Rodrig087/Digitalizador/Leeme.txt

Contiene los archivos de hardware, software y firmware de un digitalizador de 3 canales y 12 bits de resolucion.
