Rodrig087/Digitalizador/Documentacion/Esquematico_V2.pdf

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
Altium Limited
L3, 12a Rodborough Rd
Frenchs Forest
NSW
* | Australia 2086

*

* | *
7/12/2021 | 19:02:05
G:\My Drive\IVAN PALACIOS\Digitalizador\Digitalizador 3 Canales - RPi\PCB\Digitalizador_RPi_V2\Digitalizador_RPi\Digitalizador_RPi.SchDoc

Title

Size: | Number:
Date:
File:

Revision:
Time: | Sheet | of

A1

## ENTRADA Y SALIDA DE ALIMENTACIONES - CONEXIÓN GEÓFONO Y ACELERÓMETRO ETNA

20pF

1 2

C25

CL21C200JBANNNC

20pF

1 2

C26

CL21C200JBANNNC

MCLR 1
AN0/VREF+/CN2/RB0 2
AN1/VREF-/CN3/RB1 3
AN2/SS1/LVDIN/CN4/RB2 4
AN3/CN5/RB3 5
AN4/IC7/CN6/RB4 6
AN5/IC8/CN7/RB5 7
PGC/EMUC/AN6/OCFA/RB6 8
PGD/EMUD/AN7/RB7 9
AN8/RB8 10
VDD_1 11
VSS_1 12
OSC1/CLKI 13
OSC2/CLKO/RC15 14
EMUD1/SOSCI/T2CK/U1ATX/CN1/RC13 15 EMUC1/SOSCO/T1CK/U1ARX/CN0/RC14 16 INT0/RA11 17
IC2/INT2/RD9 18
OC4/RD3 19
VSS_2 20
AVDD | 40
AVSS | 39
AN9/CSCK/RB9 | 38
AN10/CSDI/RB10 | 37
AN11/CSDO/RB11 | 36
AN12/COFS/RB12 | 35
EMUC2/OC1/RD0 | 34
EMUD2/OC2/RD1 | 33
VDD_3 | 32
VSS_3 | 31
C1RX/RF0 | 30
C1TX/RF1 | 29
U2RX/CN17/RF4 | 28
U2TX/CN18/RF5 | 27
U1RX/SDI1/SDA/RF2 | 26
EMUD3/U1TX/SDO1/SCL/RF3 | 25
EMUC3/SCK1/RF6 | 24
IC1/INT1/RD8 | 23
OC3/RD2 | 22
VDD_2 | 21

IC2

DSPIC30F4013-30I_P

100nF ¹ 2
C20

10nF ¹ 2
C21 1 2 D1

1N4148W

4K7 ¹ ² R13
0603WAF4701T5E

MCLR

+5V

GND

OSC1

OSC2

OSC1
OSC2

+5V

GND 1 2

Y1
ECS-150-S-4X

PGC_A3_5V
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
PEINETA-6X1P GRABADOR

MCLR

+5V

GND

PGC_A3_5V

PGD

A2_5V

A1_5V

A0_5V

VREF_+5V
SIGNAL3
SIGNAL2
SIGNAL1

TX_GPS_5V

RX_GPS

EN_GPS

+5V_AVDD
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
PPS_GPS_5V

## DISPOSITIVO PRINCIPAL DSPIC30F4013 Y ADC

1uF ¹ 2
C19

100nF ¹ 2
C23

10nF ¹ 2
C24

+5V_AVDD

GND

1uF ¹ 2
C22

## CONVERSORES DE NIVEL PARA MULTIPLEXORES

2 3 ¹

Q6
2N7002

+2.5V +5V

A0_2.5V | A0_5V

2 3 ¹

Q11
2N7002

+2.5V +5V

A1_2.5V | A1_5V

1K ¹ 2
R20

1K ¹ 2
R21

1K ¹ 2
R38

1K ¹ 2
R39

2 3 ¹

Q7
2N7002

+2.5V +5V

A2_2.5V | A2_5V

2 3 ¹

Q12
2N7002

+2.5V +5V

A3_2.5V | PGC_A3_5V

1K ¹ 2
R22

1K ¹ 2
R23

1K ¹ 2
R40

1K ¹ 2
R41
PPS_DS3231 | SDA_DS3231

RST_DS3231

SCL_DS3231

MOSI_RPI_5V
MISO_RPI_5V
SCK_RPI_5V

CS_RPI_5V

PIN_EXTRA_5V

INT_FROM_PIC_5V

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
Blue

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
CH1+
CH1-
CH2+
CH2-
CH3+
CH3-

1
2
3
4
5
6

P3

SEÑALES GEOFONO

1
2
3
4

P4

ALIMENTACION GEOFONO
+12V
-12V

GND

100nF ¹ 2
C8

-12V

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
11 11
13 13
15 15
17 17
19 19

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
10 10
12 12
14 14
16 16
18 18
20 20

J1

CONECTOR ACELEROMETRO

CH3+

CH2-

CH3-

CH1+

CH2+

CH1- -12V

GND

+12V

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
ENTRADA_ALIMENTACION_1

GND

+5V
+3.3V

+2.5V
-2.5V

+12V
-12V

+8V
-8V

GND

+5V_CONM

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
ENTRADA_ALIMENTACION_2

100nF ¹ 2
C7

+12V

GND

2 3 ¹

Q1
2N7002

+3.3V +5V

TX_GPS_3.3V | TX_GPS_5V

TX_GPS_3.3V
RX_GPS

EN_GPS

2 3 ¹

Q2
2N7002

+3.3V +5V

PPS_GPS_3.3V | PPS_GPS_5V
+5V

GND

PPS_GPS_3.3V

## CONEXIÓN GPS

100nF ¹ 2
C2

10nF ¹ 2
C3

+5V

GND

1uF ¹ 2
C1
1K ¹ 2
R4

1K ¹ 2
R5

1K ¹ 2
R8

1K ¹ 2
R9

## REFERENCIA DE VOLTAJES +5V Y +2.5V

VDD 1
DATA 2
NULL 3
GND 4

IC3

DHT22

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
11 11
13 13
15 15
17 17
19 19
21 21
23 23
25 25
27 27
29 29
31 31
33 33
35 35
37 37
39 39

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
10 10
12 12
14 14
16 16
18 18
20 20
22 22
24 24
26 26
28 28
30 30
32 32
34 34
36 36
38 38
40 40

J2

PEINETA-2X20P

+3.3V

GND | GND

+5V_CONM

GND

+3.3V | +5V_CONM

GND

GND

GND

GND

GND

GND

GND

+3.3V

100nF ¹ 2
C17

10nF ¹ 2
C18

10nF ¹ 2
C16

100nF ¹ 2
C15

2 3 ¹

Q4
2N7002

+3.3V +5V

MOSI_RPI_3.3V | MOSI_RPI_5V

1K ¹ 2
R14

1K ¹ 2
R15

2 3 ¹

Q9
2N7002

+3.3V +5V

SCK_RPI_3.3V | SCK_RPI_5V

1K ¹ 2
R34

1K ¹ 2
R35

2 3 ¹

Q5
2N7002

+3.3V +5V

MISO_RPI_3.3V | MISO_RPI_5V

1K ¹ 2
R16

1K ¹ 2
R17

2 3 ¹

Q10
2N7002

+3.3V +5V

CS_RPI_3.3V | CS_RPI_5V

1K ¹ 2
R36

1K ¹ 2
R37

MOSI_RPI_3.3V
MISO_RPI_3.3V
SCK_RPI_3.3V | CS_RPI_3.3V

+3.3V

10K ¹ ² R24

GND

2 3 ¹

Q8
2N7002

+3.3V +5V

RST_DSPIC_3.3V | MCLR

1K ¹ 2
R25

1K ¹ 2
R26

2 3 ¹

Q13
2N7002

+3.3V +5V

INT_FROM_PIC_3.3V | INT_FROM_PIC_5V

1K ¹ 2
R43

1K ¹ 2
R44

2 3 ¹

Q3
2N7002

+3.3V +5V

PIN_EXTRA_3.3V | PIN_EXTRA_5V

1K ¹ 2
R11

1K ¹ 2
R12

## CONECTOR PARA RASPBERRY PI

## CONVERTIDORES DE NIVEL Y SENSOR DE TEMPERATURA Y HUMEDAD

R291 | | 2 47R
R301 | | 2 47R
R31 | 47R 1 | 2 47R | R321 | 2
R271 | 2 47R INT_FROM_PIC_3.3V
R451 | 2 47R
R461 | 2 47R | RST_DSPIC_3.3V
| | PIN_EXTRA_3.3V

Red

2 1

D4

Blue

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
OUT1F 1
OUT1S 2
GND_1 3
EN2 4
IN2 5
IN1 | 10
EN1 | 9
GND_2 | 8
OUT2S | 7
OUT2F | 6

IC1

MAX6072AAUB50+

GND

VREF_+5V

VREF_+2.5V

GND

GND

+5V

+5V

GND

1uF ¹ 2
C4

100nF ¹ 2
C5

10nF ¹ 2
C6

1uF ¹ 2
C9

100nF ¹ 2
C10

10nF ¹ 2
C11

10R

1 2

R1

10R

1 2

R6 | 1 2

BT1
CR1220-2ZX

32KHZ 1
VCC 2
NT/SQW 3
RST 4
N.C._1 5
N.C._2 6
N.C._3 7
N.C._4 8
SCL | 16
SDA | 15
VBAT | 14
GND | 13
N.C._8 | 12
N.C._7 | 11
N.C._6 | 10
N.C._5 | 9

U1

DS3231S#

GND

SDA_DS3231

+5V

GND

10nF ¹ 2
C14

100nF ¹ 2
C13

1uF ¹ 2
C12

+5V

GND | GND

4K7 ¹ ² R3

0805W8F4701T5E 4K7 1 2 R2
0805W8F4701T5E

+5V

SCL_DS3231 4K7 1 2 R7
0805W8F4701T5E

RST_DS3231

PPS_DS3231

## RELOJ EN TIEMPO REAL DS3231

RG_1 1
V-IN 2
V+IN 3
V- 4
RG_2 | 8
V+ | 7
VO | 6
REF | 5

IC5

INA114AP

VDD 1
NC_1 2
NC_2 3
S16 4
S15 5
S14 6
S13 7
S12 8
S11 9
S10 10
S9 11
GND 12
NC_3 13
A3 14

D

28
VSS | 27
S8 | 26
S7 | 25
S6 | 24
S5 | 23
S4 | 22
S3 | 21
S2 | 20
S1 | 19
EN | 18
A0 | 17
A1 | 16
A2 | 15

IC4

ADG706BRUZ-REEL7 | -8V

GND

+8V_INA_CH1

| -8V_INA_CH1
| A0_2.5V
| A1_2.5V
A3_2.5V | A2_2.5V +2.5V

+2.5V

GND

100nF ¹ 2
C36

-2.5V

GND

100nF ¹ 2
C37

+2.5V

GND

-2.5V

RES_1_1

IND | R54
IND | R52
22R 1 | 2R59
R53 | 1.62k
R551 | 2 3K3
R60 | 16.5k
R68 | IND
R71 | IND

RES_1_2

RES_1_2

RES_1_1 | RES_1_2

20K ¹ ² R56

20K ¹ ² R72

1nF 1 2 | C35
1nF 1 2 | C39 | 10nF ¹ ² C38
CL10B103KB8NNNC

CH1+

CH1-

GND | GND

CH1+_ACON

CH1-_ACON

CH1+_ACON

CH1-_ACON
3K3

1 2

R61

4K7

1 2

R65

680nF

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
VREF_+2.5V

1K

1 2

R79

1K 1 2 R80

GND

SIGNAL1

## ACONDICIONAMIENTO DE SEÑAL PARA EL CANAL 1

10R 1 | 2R57
47R 1 | 2R63
100R 1 | 2R67
180R 1 | 2R70
390R 1 | 2R73
R511 | 2 820R
100R

1 2

R50

100R

1 2

R76

100R

1 2

R49

100R

1 2

R75

47R

1 2

R78

-8V_INA_CH1

GND

10nF ¹ 2
C47

100nF ¹ 2
C46

1uF ¹ 2
C45

+8V

47R

1 2

R77

+8V_INA_CH1

GND

10nF ¹ 2
C44

100nF ¹ 2
C43

1uF ¹ 2
C42

-8V

47R

1 2

R48

-8V_TL_CH1

GND

10nF ¹ 2
C34

100nF ¹ 2
C33

1uF ¹ 2
C32

+8V

47R

1 2

R47

+8V_TL_CH1

GND

10nF ¹ 2
C31

100nF ¹ 2
C30

1uF ¹ 2
C29
R581 | 2 6K8
R641 | 2 49.9K
8K2

1 2

R62

18K

1 2

R66

68nF 1 2

330nF | C41 ¹ 2
C40

470nF

1 2

C27

RG_1 1
V-IN 2
V+IN 3
V- 4
RG_2 | 8
V+ | 7
VO | 6
REF | 5

IC7

INA114AP

VDD 1
NC_1 2
NC_2 3
S16 4
S15 5
S14 6
S13 7
S12 8
S11 9
S10 10
S9 11
GND 12
NC_3 13
A3 14

D

28
VSS | 27
S8 | 26
S7 | 25
S6 | 24
S5 | 23
S4 | 22
S3 | 21
S2 | 20
S1 | 19
EN | 18
A0 | 17
A1 | 16
A2 | 15

IC6

ADG706BRUZ-REEL7 | -8V

GND

+8V_INA_CH2

| -8V_INA_CH2
| A0_2.5V
| A1_2.5V
A3_2.5V | A2_2.5V +2.5V

+2.5V

GND

100nF ¹ 2
C57

-2.5V

GND

100nF ¹ 2
C58

+2.5V

GND

-2.5V

RES_2_1

IND | R88
IND | R86
22R 1 | 2R93
R87 | 1.62k
R891 | 2 3K3
R94 | 16.5k

R102 IND
R105 IND

RES_2_2

RES_2_2

RES_2_1 | RES_2_2

20K ¹ ² R90

20K ¹ ² R106

1nF 1 2 | C56
1nF 1 2 | C60 | 10nF ¹ ² C59
CL10B103KB8NNNC

CH2+

CH2-

GND | GND

CH2+_ACON

CH2-_ACON

CH2+_ACON

CH2-_ACON
3K3

1 2

R95

4K7

1 2

R99

680nF

C49

Cap

1K

1 2

R103

GND
GND

1K

1 2

R108
VREF_+2.5V

1K

1 2

R113

1K 1 2 R114

GND

SIGNAL2

## ACONDICIONAMIENTO DE SEÑAL PARA EL CANAL 2

10R 1 | 2R91
47R 1 | 2R97
100R 1 | 2R101
180R 1 | 2R104
390R 1 | 2R107
R851 | 2 820R
100R

1 2

R84

100R

1 2

R110

100R

1 2

R83

100R

1 2

R109

47R

1 2

R112

-8V_INA_CH2

GND

10nF ¹ 2
C68

100nF ¹ 2
C67

1uF ¹ 2
C66

+8V

47R

1 2

R111

+8V_INA_CH2

GND

10nF ¹ 2
C65

100nF ¹ 2
C64

1uF ¹ 2
C63

-8V

47R

1 2

R82

-8V_TL_CH2

GND

10nF ¹ 2
C55

100nF ¹ 2
C54

1uF ¹ 2
C53

+8V

47R

1 2

R81

+8V_TL_CH2

GND

10nF ¹ 2
C52

100nF ¹ 2
C51

1uF ¹ 2
C50
R921 | 2 6K8
R981 | 2 49.9K
8K2

1 2

R96

18K

1 2

R100

68nF 1 2

330nF | C62 ¹ 2
C61

470nF

1 2

C48

RG_1 1
V-IN 2
V+IN 3
V- 4
RG_2 | 8
V+ | 7
VO | 6
REF | 5

IC9

INA114AP

VDD 1
NC_1 2
NC_2 3
S16 4
S15 5
S14 6
S13 7
S12 8
S11 9
S10 10
S9 11
GND 12
NC_3 13
A3 14

D

28
VSS | 27
S8 | 26
S7 | 25
S6 | 24
S5 | 23
S4 | 22
S3 | 21
S2 | 20
S1 | 19
EN | 18
A0 | 17
A1 | 16
A2 | 15

IC8

ADG706BRUZ-REEL7 | -8V

GND

+8V_INA_CH3

| -8V_INA_CH3
| A0_2.5V
| A1_2.5V
A3_2.5V | A2_2.5V +2.5V

+2.5V

GND

100nF ¹ 2
C78

-2.5V

GND

100nF ¹ 2
C79

+2.5V

GND

-2.5V

RES_3_1

IND | R122
IND | R120
22R 1 | 2R127

R121 1.62k
R1231 2 3K3

R128 16.5k

R136 IND
R139 IND

RES_3_2

RES_3_2

RES_3_1 | RES_3_2

20K ¹ ² R124

20K ¹ ² R140

1nF 1 2 | C77
1nF 1 2 | C81 | 10nF ¹ ² C80
CL10B103KB8NNNC

CH3+

CH3-

GND | GND

CH3+_ACON

CH3-_ACON

CH3+_ACON

CH3-_ACON
3K3

1 2

R129

4K7

1 2

R133

680nF

C70

Cap

1K

1 2

R137

GND
GND

1K

1 2

R142
VREF_+2.5V

1K

1 2

R147

1K 1 2 R148

GND

SIGNAL3

## ACONDICIONAMIENTO DE SEÑAL PARA EL CANAL 3

10R 1 | 2R125
47R 1 | 2R131
100R 1 | 2R135
180R 1 | 2R138
390R 1 | 2R141
R1191 | 2 820R
100R

1 2

R118

100R

1 2

R144

100R

1 2

R117

100R

1 2

R143

47R

1 2

R146

-8V_INA_CH3

GND

10nF ¹ 2
C89

100nF ¹ 2
C88

1uF ¹ 2
C87

+8V

47R

1 2

R145

+8V_INA_CH3

GND

10nF ¹ 2
C86

100nF ¹ 2
C85

1uF ¹ 2
C84

-8V

47R

1 2

R116

-8V_TL_CH3

GND

10nF ¹ 2
C76

100nF ¹ 2
C75

1uF ¹ 2
C74

+8V

47R

1 2

R115

+8V_TL_CH3

GND

10nF ¹ 2
C73

100nF ¹ 2
C72

1uF ¹ 2
C71
R1261 | 2 6K8
R1321 | 2 49.9K
8K2

1 2

R130

18K

1 2

R134

68nF 1 2

330nF | C83 ¹ 2
C82

470nF

1 2

C69

1PPS 0

VIN 1

GND 2

RXD 3

TXD 4

FIX 5

VBAT 6

EN 7

3.3V 8

GPS1

GPS-BREAKOUT-V3

7
6

5

U2B

TL084IDR

+8V_TL_CH1

-8V_TL_CH1 -+

1
2
3 | 4 11 | U2A
| | TL084IDR

7
6

5

U3B

TL084IDR

+8V_TL_CH2

-8V_TL_CH2 -+

1
2
3 | 4 11 | U3A
| | TL084IDR

7
6

5

U4B

TL084IDR

+8V_TL_CH3

-8V_TL_CH3 -+

1
2
3 | 4 11 | U4A
| | TL084IDR

Filtro pasa
bajas para la
alimentación
analógica

Las resistencias de 47R en los pines de comunicación con el dsPIC son para reducir las oscilaciones de alta frecuencia que ocurren cuando hay una conmutación, conocido como ringing

A las salidas se coloca una resistencia y los capacitores para formar un filtro pasa bajas y eliminar el ruido con frecuencia de corte f = 1/(2*pi*R*C)

Multiplexor para modificar la ganancia del amplificador

Etapa de acondicionamiento de la señal del geófono antes de amplificar

Filtro pasa bajas Butterworth tipo Sallen Key de 80 Hz de 4to orden

Agrega un offset para tener solo señales positivas (entre 0 y 5V) y al final un seguidor de tensión

Se agrega un filtro pasa bajas RC en cada alimentación (+8V y -8V) tanto del INA114 como del TL084, esto con el objetivo de eliminar las frecuencias altas no deseadas. La frecuencia de corte del filtro es f = 1/(2*pi*R*C)

Multiplexor para modificar la ganancia del amplificador

Etapa de acondicionamiento de la señal del geófono antes de amplificar

Filtro pasa bajas Butterworth tipo Sallen Key de 80 Hz de 4to orden

Agrega un offset para tener solo señales positivas (entre 0 y 5V) y al final un seguidor de tensión

Se agrega un filtro pasa bajas RC en cada alimentación (+8V y -8V) tanto del INA114 como del TL084, esto con el objetivo de eliminar las frecuencias altas no deseadas. La frecuencia de corte del filtro es f = 1/(2*pi*R*C)

Multiplexor para modificar la ganancia del amplificador

Etapa de acondicionamiento de la señal del geófono antes de amplificar

Filtro pasa bajas Butterworth tipo Sallen Key de 80 Hz de 4to orden

Agrega un offset para tener solo señales positivas (entre 0 y 5V) y al final un seguidor de tensión

Se agrega un filtro pasa bajas RC en cada alimentación (+8V y -8V) tanto del INA114 como del
TL084, esto con el objetivo de eliminar las
frecuencias altas no deseadas. La frecuencia de corte
del filtro es f = 1/(2*pi*R*C) | -+

8
9

10

U4C
TL084IDR -+
14
13

12

U4D

TL084IDR

8
9

10

U3C
TL084IDR -+
14
13

12

U3D

TL084IDR

8
9

10

U2C
TL084IDR -+
14
13

12

U2D

TL084IDR
