Rodrig087/Digitalizador/Documentacion/Filtro_Pasa_Bajas_Butterworth_80Hz.PNG

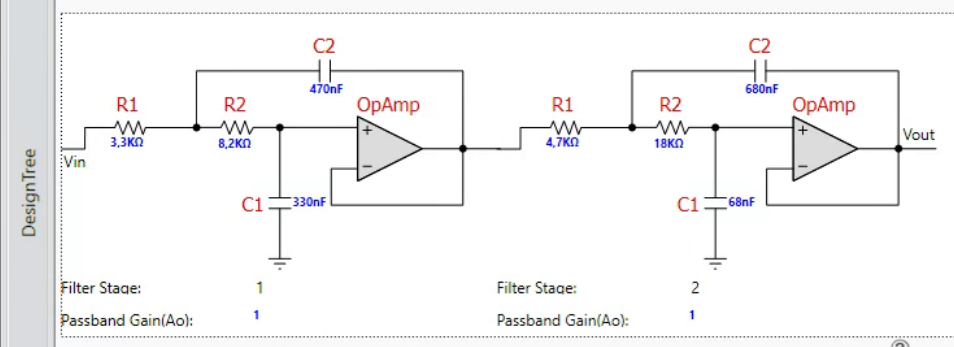
Documentacion/Filtro_Pasa_Bajas_Butterworth_80Hz.PNG
