Rodrig087/Digitalizador/PCBs/V2/Digitalizador_RPi/Project Outputs for Digitalizador_RPi/Digitalizador_RPi_BOM.xls

Comment | Designator | Footprint | JLCPCB Part #
1N4148W | D1 | SOD3716X135N | C81598
2N7002 | Q1, Q2, Q3, Q4, Q5, Q6, Q7, Q8, Q9, Q10, Q11, Q12, Q13 | SOT96P240X120-3N | C8545
0603B103K500NT | C3, C6, C11, C14, C16, C18, C21, C24, C31, C34, C38, C44, C47, C52, C55, C59, C65, C68, C73, C76, C80, C86, C89 | CAPC1608X90N | C57112
0603B334K250NT | C40, C61, C82 | CAPC1608X90N | C1615
0603WAF4701T5E | R13 | RES-0603-RFS | C23162
0805W8F100JT5E | R1, R6, R10, R18, R57, R91, R125 | RESC2013X65N | C17415
0805W8F220JT5E | R59, R93, R127 | RESC2013X65N | C17561
0805W8F470JT5E | R27, R29, R30, R31, R32, R45, R46, R47, R48, R63, R77, R78, R81, R82, R97, R111, R112, R115, R116, R131, R145, R146 | RESC2013X65N | C17714
0805W8F1000T5E | R49, R50, R67, R75, R76, R83, R84, R101, R109, R110, R117, R118, R135, R143, R144 | RESC2013X65N | C17408
0805W8F1001T5E | R4, R5, R8, R9, R11, R12, R14, R15, R16, R17, R20, R21, R22, R23, R25, R26, R33, R34, R35, R36, R37, R38, R39, R40, R41, R42, R43, R44, R69, R74, R79, R80, R103, R108, R113, R114, R137, R142, R147, R148 | RESC2012X50N | C17513
0805W8F1002T5E | R24 | RESC2012X50N | C17414
0805W8F1800T5E | R70, R104, R138 | RESC2013X65N | C25270
0805W8F1802T5E | R66, R100, R134 | RESC2013X65N | C17506
0805W8F2002T5E | R56, R72, R90, R106, R124, R140 | RESC2012X50N | C4328
0805W8F3301T5E | R55, R61, R89, R95, R123, R129 | RESC2013X65N | C26010
0805W8F3900T5E | R73, R107, R141 | RESC2013X65N | C17655
0805W8F4701T5E | R2, R3, R7, R19, R28, R65, R99, R133 | RESC2012X50N | C17673
0805W8F4992T5E | R64, R98, R132 | RESC2013X65N | C17719
0805W8F6801T5E | R58, R92, R126 | RESC2013X65N | C17772
0805W8F8200T5E | R51, R85, R119 | RESC2013X65N | C17837
0805W8F8201T5E | R62, R96, R130 | RESC2013X65N | C17828
CC0603KRX7R9BB104 | C2, C5, C7, C8, C10, C13, C15, C17, C20, C23, C30, C33, C36, C37, C43, C46, C51, C54, C57, C58, C64, C67, C72, C75, C78, C79, C85, C88 | CAPC1608X90N | C14663
CL10A105KB8NNNC | C1, C4, C9, C12, C19, C22, C29, C32, C42, C45, C50, C53, C63, C66, C71, C74, C84, C87 | CAPC1608X90N | C15849
CL10B102KB8NNNC | C35, C39, C56, C60, C77, C81 | CAPC1608X90N | C1588
CL10B474KA8NNNC | C27, C48, C69 | CAPC1608X90N | C1623
CL10B683KB8NNNC | C41, C62, C83 | CAPC1608X90N | C31658
CL21C200JBANNNC | C25, C26 | CAPC2012X75N | C1798
CR1220-2ZX | BT1 | CR12202ZX | C969906
NCD0805R1 | D2, D4 | LED-0805-R-RFS | C84256
TL084IDR | U2, U3, U4 | SOIC127P600X175-14N | C12601
XL-0805QBC | D3, D5 | LED-0805-B-RFS | C2293
