Rodrig087/Digitalizador/Documentacion/Esquematico_V1.pdf

## REFERENCIA PARA EL OFFSET EN LAS SEÑALES

## ALIMENTACIÓN GEOFONO Y SEÑALES DE ENTRADA

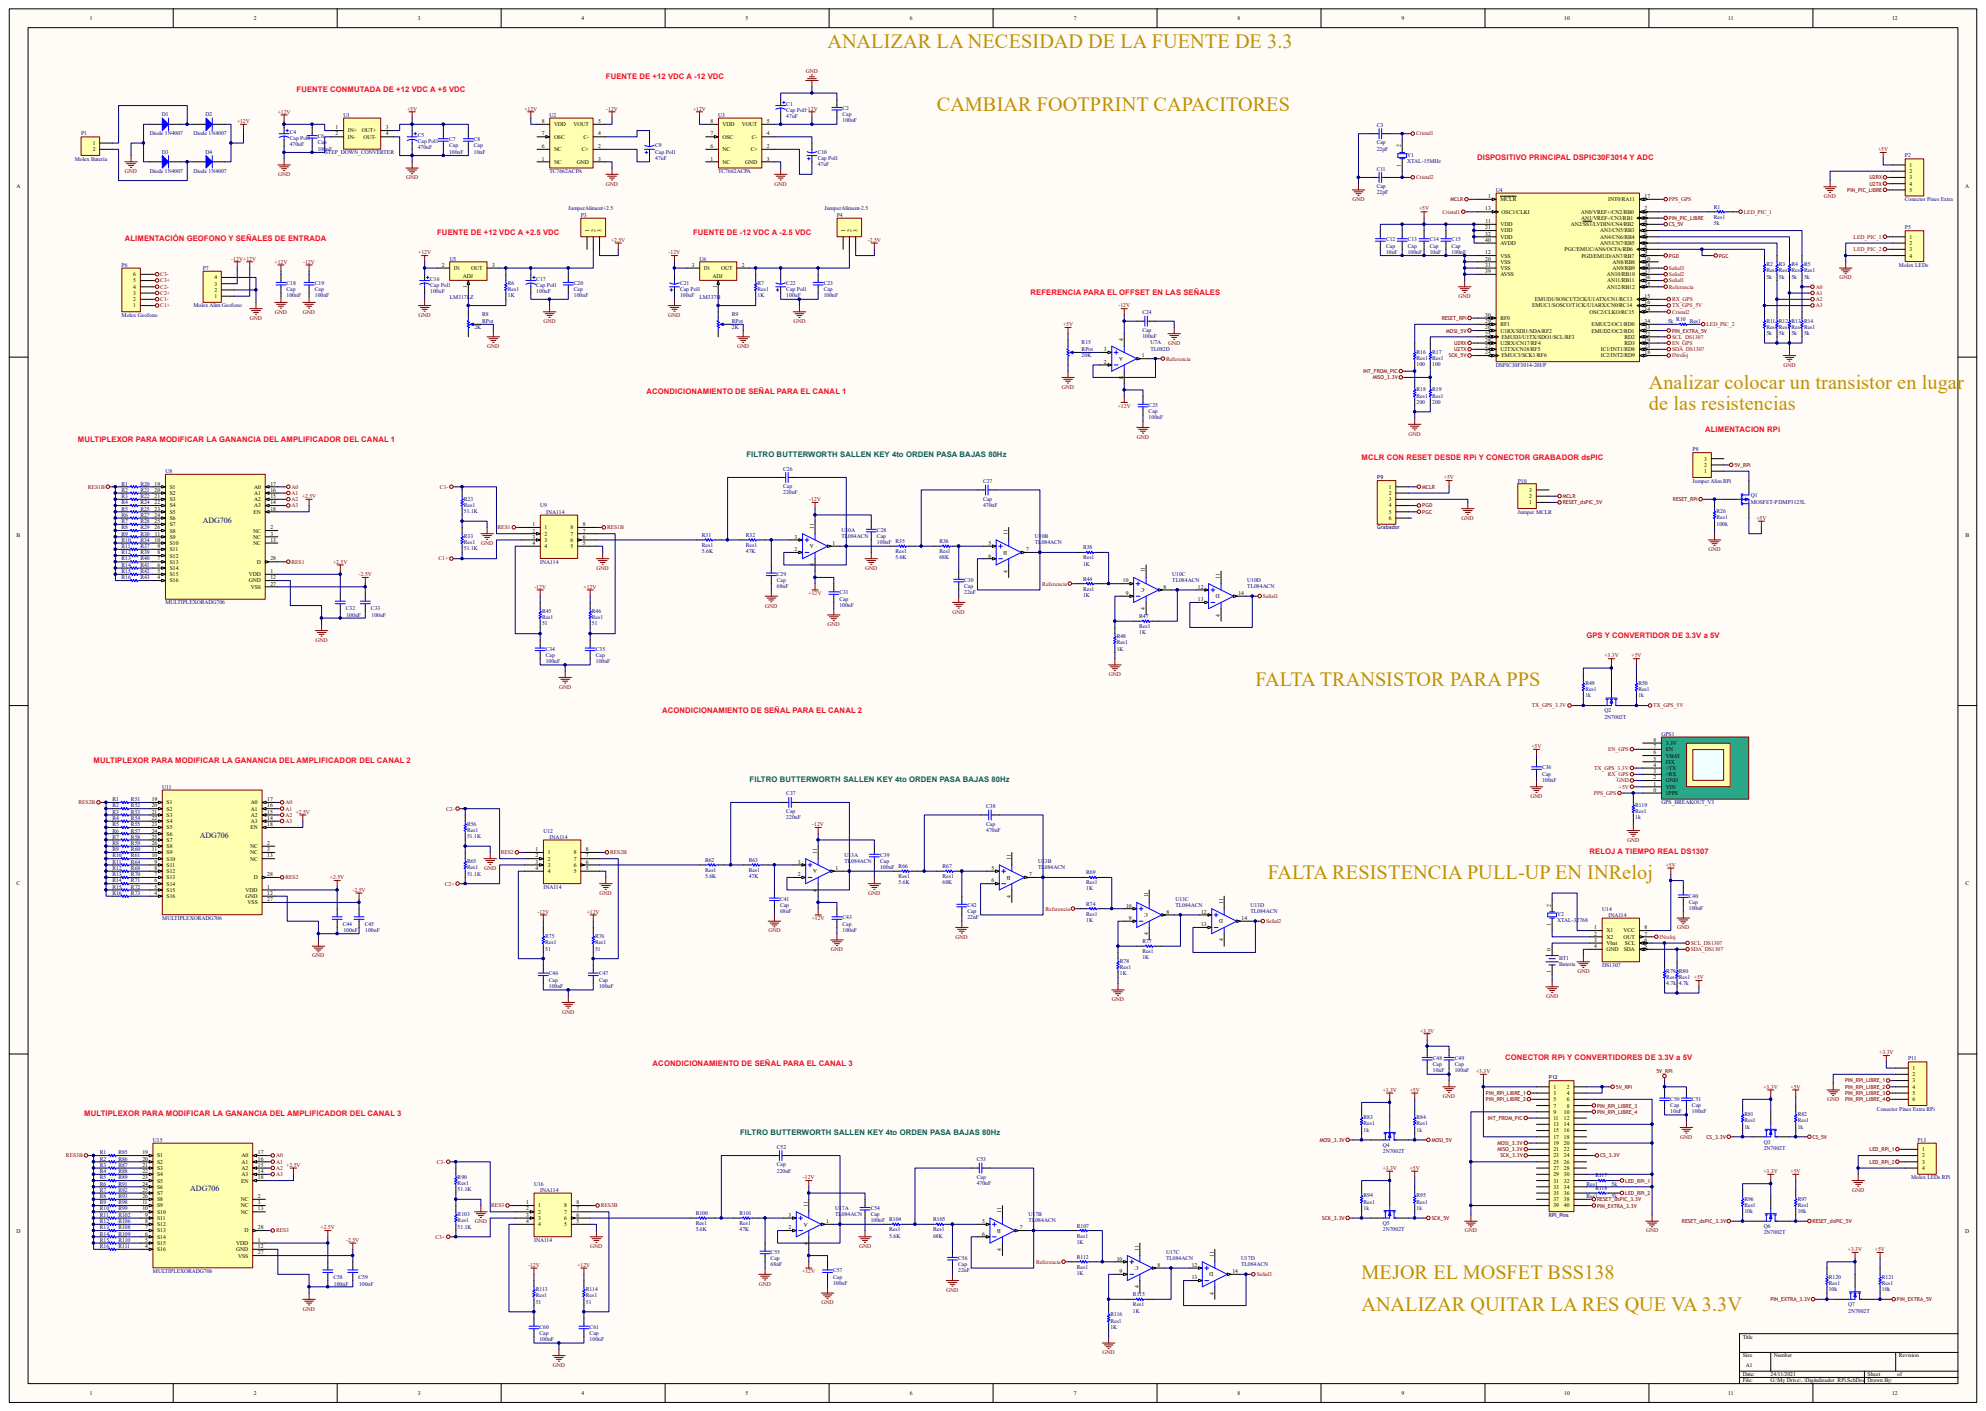
[picture p2: page 1]

ANALIZAR LA NECESIDAD DE LA FUENTE DE 3.3

FUENTE DE +12 VDC A -12 VDC

FUENTE CONMUTADA DE +12 VDC A +5 VDC

ACONDICIONAMIENTO DE SEÑAL PARA EL CANAL 1

MULTIPLEXOR PARA MODIFICAR LA GANANCIA DEL AMPLIFICADOR DEL CANAL 1

FILTRO BUTTERWORTH SALLEN KEY 4to ORDEN PASA BAJAS 80Hz

MCLR CON RESET DESDE RPi Y CONECTOR GRABADOR dsPIC

FALTA TRANSISTOR PARA PPS

ACONDICIONAMIENTO DE SEÑAL PARA EL CANAL 2

MULTIPLEXOR PARA MODIFICAR LA GANANCIA DEL AMPLIFICADOR DEL CANAL 2

FALTA RESISTENCIA PULL-UP EN INReloj

CONECTOR RPi Y CONVERTIDORES DE 3.3V a 5V

ACONDICIONAMIENTO DE SEÑAL PARA EL CANAL 3

MULTIPLEXOR PARA MODIFICAR LA GANANCIA DEL AMPLIFICADOR DEL CANAL 3

Conector Pines Extra RPi

ANALIZAR QUITAR LA RES QUE VA 3.3V
