Rodrig087/Digitalizador/(list of files, drawings)

Other design files:
PCBs/V1/Digitalizador_RPi/Digitalizador_RPi (Copia en conflicto de Ivan Palacios 2020-06-25).SchDoc
PCBs/V1/Digitalizador_RPi/Digitalizador_RPi.PrjPcb
PCBs/V1/Digitalizador_RPi/Digitalizador_RPi.SchDoc
PCBs/V2/Digitalizador_RPi/Digitalizador_RPi.PrjPcb
PCBs/V2/Digitalizador_RPi/Digitalizador_RPi.SchDoc
PCBs/V2/Fuente_Alimentacion/Fuente_Alimentacion.PcbDoc
PCBs/V2/Fuente_Alimentacion/Fuente_Alimentacion.PrjPcb
PCBs/V2/Fuente_Alimentacion/Fuente_Alimentacion.SchDoc
