Rodrig087/Digitalizador/Firmware/Librerias/DS3231_Functions.c

///////////////////////////////////////////////////////////////////////////
////                                                                   ////
////                             DS3231.c                              ////
////                                                                   ////
////                     Driver for mikroC compiler                    ////
////                                                                   ////
////     Driver for Maxim DS3231 serial I2C real-time clock (RTC).     ////
////                                                                   ////
///////////////////////////////////////////////////////////////////////////
////                                                                   ////
////                     https://simple-circuit.com/                   ////
////                                                                   ////
///////////////////////////////////////////////////////////////////////////



#define RTC_I2C_START Soft_I2C_Start
#define RTC_I2C_RESTART Soft_I2C_Start
#define RTC_I2C_WRITE Soft_I2C_Write
#define RTC_I2C_READ Soft_I2C_Read
#define RTC_I2C_STOP Soft_I2C_Stop


#include <stdint.h>

#define DS3231_ADDRESS 0xD0
#define DS3231_REG_SECONDS 0x00
#define DS3231_REG_AL1_SEC 0x07
#define DS3231_REG_AL2_MIN 0x0B
#define DS3231_REG_CONTROL 0x0E
#define DS3231_REG_STATUS 0x0F
#define DS3231_REG_TEMP_MSB 0x11

typedef enum
{
  SUNDAY = 1,
  MONDAY,
  TUESDAY,
  WEDNESDAY,
  THURSDAY,
  FRIDAY,
  SATURDAY
} RTC_DOW;

typedef enum
{
  JANUARY = 1,
  FEBRUARY,
  MARCH,
  APRIL,
  MAY,
  JUNE,
  JULY,
  AUGUST,
  SEPTEMBER,
  OCTOBER,
  NOVEMBER,
  DECEMBER
} RTC_Month;

typedef struct rtc_tm
{
  uint8_t seconds;
  uint8_t minutes;
  uint8_t hours;
  RTC_DOW dow;
  uint8_t day;
  uint8_t month;
  uint8_t year;
} RTC_Time;

typedef enum
{
  ONCE_PER_SECOND = 0x0F,
  SECONDS_MATCH = 0x0E,
  MINUTES_SECONDS_MATCH = 0x0C,
  HOURS_MINUTES_SECONDS_MATCH = 0x08,
  DATE_HOURS_MINUTES_SECONDS_MATCH = 0x0,
  DAY_HOURS_MINUTES_SECONDS_MATCH = 0x10
} al1;

typedef enum
{
  ONCE_PER_MINUTE = 0x0E,
  MINUTES_MATCH = 0x0C,
  HOURS_MINUTES_MATCH = 0x08,
  DATE_HOURS_MINUTES_MATCH = 0x0,
  DAY_HOURS_MINUTES_MATCH = 0x10
} al2;

typedef enum
{
  OUT_OFF = 0x00,
  OUT_INT = 0x04,
  OUT_1Hz = 0x40,
  OUT_1024Hz = 0x48,
  OUT_4096Hz = 0x50,
  OUT_8192Hz = 0x58
} INT_SQW;

RTC_Time c_time, c_alarm1, c_alarm2;

///////////////////////// All Functions /////////////////////////
                                                               //
uint8_t bcd_to_decimal(uint8_t number);                        //
uint8_t decimal_to_bcd(uint8_t number);                        //
uint8_t alarm_cfg(uint8_t n, uint8_t i);                       //
void RTC_Set(RTC_Time *time_t);                                //
RTC_Time *RTC_Get();                                           //                                      //
void IntSqw_Set(INT_SQW _config);                              //
void Enable_32kHZ();                                           //
void Disable_32kHZ();                                          //
void OSC_Start();                                              //
void OSC_Stop();                                               //
int16_t Get_Temperature();                                     //
uint8_t RTC_Read_Reg(uint8_t reg_address);                     //
void RTC_Write_Reg(uint8_t reg_address, uint8_t reg_value);    //
                                                               //
/////////////////////////////////////////////////////////////////

// converts BCD to decimal
uint8_t bcd_to_decimal(uint8_t number)
{
  return ( (number >> 4) * 10 + (number & 0x0F) );
}

// converts decimal to BCD
uint8_t decimal_to_bcd(uint8_t number)
{
  return ( ((number / 10) << 4) + (number % 10) );
}

// sets time and date
void RTC_Set(RTC_Time *time_t)
{
  // convert decimal to BCD
  time_t->day     = decimal_to_bcd(time_t->day);
  time_t->month   = decimal_to_bcd(time_t->month);
  time_t->year    = decimal_to_bcd(time_t->year);
  time_t->hours   = decimal_to_bcd(time_t->hours);
  time_t->minutes = decimal_to_bcd(time_t->minutes);
  time_t->seconds = decimal_to_bcd(time_t->seconds);
  // end conversion

  // write data to the RTC chip
  RTC_I2C_START();
  RTC_I2C_WRITE(DS3231_ADDRESS);
  RTC_I2C_WRITE(DS3231_REG_SECONDS);
  RTC_I2C_WRITE(time_t->seconds);
  RTC_I2C_WRITE(time_t->minutes);
  RTC_I2C_WRITE(time_t->hours);
  RTC_I2C_WRITE(time_t->dow);
  RTC_I2C_WRITE(time_t->day);
  RTC_I2C_WRITE(time_t->month);
  RTC_I2C_WRITE(time_t->year);
  RTC_I2C_STOP();
}

// reads time and date
RTC_Time *RTC_Get()
{
  RTC_I2C_START();
  RTC_I2C_WRITE(DS3231_ADDRESS);
  RTC_I2C_WRITE(DS3231_REG_SECONDS);
  RTC_I2C_RESTART();
  RTC_I2C_WRITE(DS3231_ADDRESS | 0x01);
  c_time.seconds = RTC_I2C_READ(1);
  c_time.minutes = RTC_I2C_READ(1);
  c_time.hours   = RTC_I2C_READ(1);
  c_time.dow   = RTC_I2C_READ(1);
  c_time.day   = RTC_I2C_READ(1);
  c_time.month = RTC_I2C_READ(1);
  c_time.year  = RTC_I2C_READ(0);
  RTC_I2C_STOP();

  // convert BCD to decimal
  c_time.seconds = bcd_to_decimal(c_time.seconds);
  c_time.minutes = bcd_to_decimal(c_time.minutes);
  c_time.hours   = bcd_to_decimal(c_time.hours);
  c_time.day     = bcd_to_decimal(c_time.day);
  c_time.month   = bcd_to_decimal(c_time.month);
  c_time.year    = bcd_to_decimal(c_time.year);
  // end conversion

  return &c_time;
}


// writes 'reg_value' to register of address 'reg_address'
void RTC_Write_Reg(uint8_t reg_address, uint8_t reg_value)
{
  RTC_I2C_START();
  RTC_I2C_WRITE(DS3231_ADDRESS);
  RTC_I2C_WRITE(reg_address);
  RTC_I2C_WRITE(reg_value);
  RTC_I2C_STOP();
}

// returns the value stored in register of address 'reg_address'
uint8_t RTC_Read_Reg(uint8_t reg_address)
{
  uint8_t reg_data;

  RTC_I2C_START();
  RTC_I2C_WRITE(DS3231_ADDRESS);
  RTC_I2C_WRITE(reg_address);
  RTC_I2C_RESTART();
  RTC_I2C_WRITE(DS3231_ADDRESS | 0x01);
  reg_data = RTC_I2C_READ(0);
  RTC_I2C_STOP();

  return reg_data;
}

// sets INT/SQW pin configuration
void IntSqw_Set(INT_SQW _config)
{
  uint8_t ctrl_reg = RTC_Read_Reg(DS3231_REG_CONTROL);
  ctrl_reg &= 0xA3;
  ctrl_reg |= _config;
  RTC_Write_Reg(DS3231_REG_CONTROL, ctrl_reg);
}

// enables 32kHz (pin 32kHz)
void Enable_32kHZ()
{
  uint8_t stat_reg = RTC_Read_Reg(DS3231_REG_STATUS);
  stat_reg |= 0x08;
  RTC_Write_Reg(DS3231_REG_STATUS, stat_reg);
}

// disables 32kHz (pin 32kHz)
void Disable_32kHZ()
{
  uint8_t stat_reg = RTC_Read_Reg(DS3231_REG_STATUS);
  stat_reg &= 0xF7;
  RTC_Write_Reg(DS3231_REG_STATUS, stat_reg);
}

// starts RTC oscillator
void OSC_Start()
{
  uint8_t ctrl_reg = RTC_Read_Reg(DS3231_REG_CONTROL);
  ctrl_reg &= 0x7F;
  RTC_Write_Reg(DS3231_REG_CONTROL, ctrl_reg);
}

// stops RTC oscillator
void OSC_Stop()
{
  uint8_t ctrl_reg = RTC_Read_Reg(DS3231_REG_CONTROL);
  ctrl_reg |= 0x80;
  RTC_Write_Reg(DS3231_REG_CONTROL, ctrl_reg);
}
