Rodrig087/Digitalizador/(commit log)

2022-05-13 Se agregaron todos los archivos del proyecto en el que trabajo Ivan
    [Componentes Similares.xlsx, Digitalizador.cfg, Digitalizador_RPi (Copia en conflicto de Ivan Palacios 2020-06-25).SchDoc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]
2022-05-27 Se agrego una nueva version del firmware para el dsPIC 30F3014.
    [Digitalizador.cfg]
2022-05-30 Se empezo la implementacion de una libreria para el manejo del RTC Ds3231. Solo funciona la parte de generar el pulso SQW.
    [Digitalizador.cfg]
2022-06-11 Se implemento una libreria para el manejo del RTC DS3231. Aun sin probar.
2022-06-30 Se implemento un programa en Python para visualizar el muestreo del digitalizador en tiempo real.
2022-07-01 Se implemento un programa en Python para graficar los datos de los 3 ejes en tiempo real
2022-07-01 Se mejoro el programa de visualizacion de los 3 ejes en tiempo real.
2022-07-02 Version final del visualizador de 3 ejes en tiempo real
2022-07-07 Se agrego un programa en Python que monitoriza cambios en un archivo
    [Compatibilidad de pines LCD.xlsx]
2022-07-16 Se modifico el programa GraficarTiempoReal_3CH.py para mostrar el grafico a pantalla completa y ocultar la barra de tareas. Funciona su
2022-07-28 Se soluciono el problema de acceso simultaneo al archivo temporal modificando el programa en C++ para que cierre el archivo despues de cada escritura, y modificando el programa en Python para que det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
2023-07-21 Se implementaron varios progrmas en Python para convertir, graficar y comprobar los archivos binarios y mseed
2023-07-24 En proceso: Implemente una funcion que grafica un intervalo. Grafica bien, pero hay un problema al mostrar el tiempo del eje x en formato hh:mm:ss.ms. El problema hace que muestre la hora duplicada a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
2023-07-25 Se corrigio la funcion graficar_intervalo y ahora funciona bien. Es necesario asegurarse de que el intervalo este dentro de los limites del archivo, ya que de no estarlo no graficara nada porque toda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
2023-07-25 Se implemento el comparador de 2 señales. Funciona bien.
